PJG05/ESP32-Peltier-PCR-Thermal-Cycler/Hardware/CIRCUITCONNECTIONS.jpeg

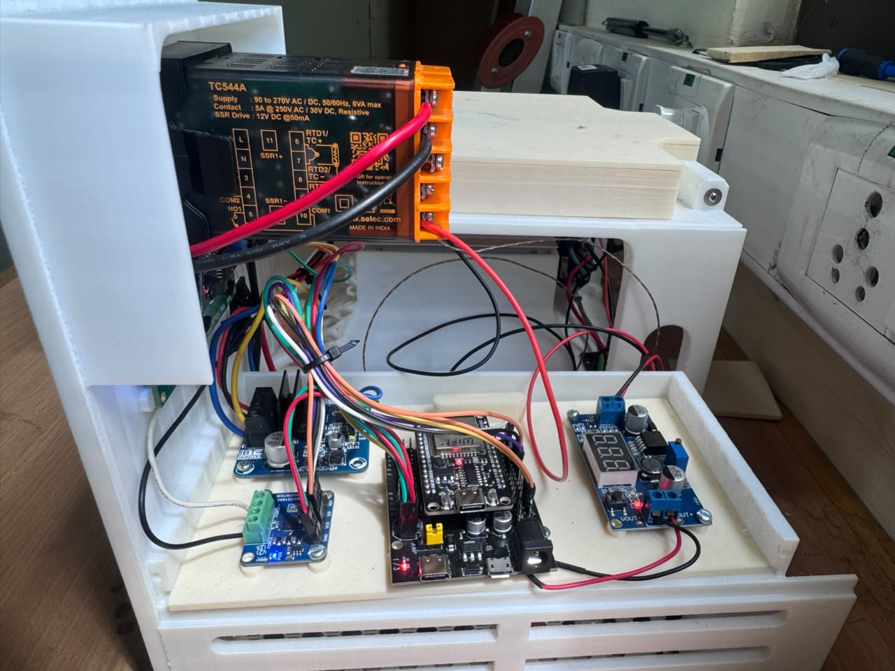
Hardware/CIRCUITCONNECTIONS.jpeg
