PJG05/ESP32-Peltier-PCR-Thermal-Cycler/Hardware/PCR.jpeg

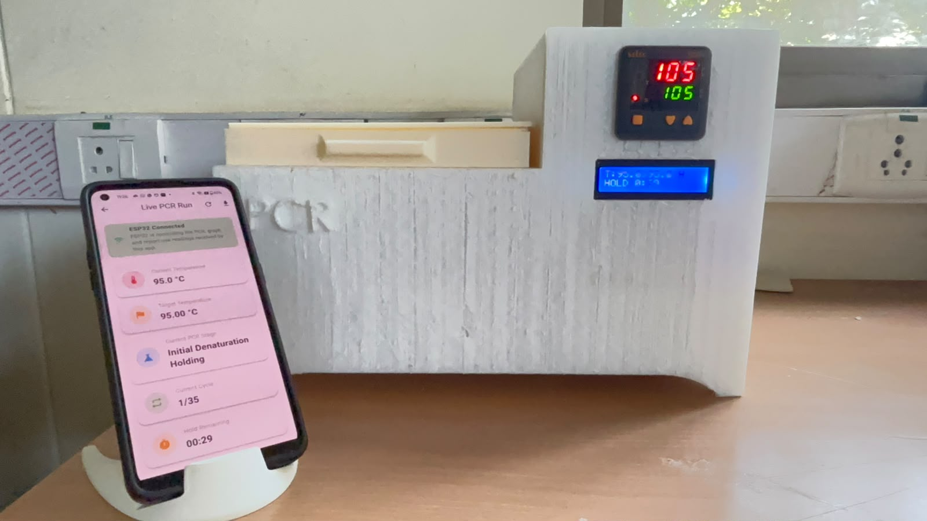
Hardware/PCR.jpeg
