PJG05/ESP32-Peltier-PCR-Thermal-Cycler/Firmware/README.md

# ESP32 Firmware

This directory contains the embedded firmware responsible for PCR temperature control, thermal cycling, telemetry, and communication.

## Main Components

- Temperature sensing and RTD interface
- PID temperature controller
- Peltier driver
- PCR state machine
- Wi-Fi HTTP server
- LCD interface
- Safety monitoring
- Telemetry and logging
