PJG05/ESP32-Peltier-PCR-Thermal-Cycler/Results/pcr_ieee_report.pdf

PCR CONTROLLER | PCR Run Report
PCR_Report_Test1_20261102_173332.pdf | Page 1 of 2

# PCR RUN REPORT

## Test1

Generated: 02/11/2026 17:33:32

## Run Summary

Parameter | Value
Program | Test1
Run Started | 02/11/2026 15:59:22
Report Generated | 02/11/2026 17:33:32
Run Duration | 1 h 34 min 9 sec
Number of Cycles | 30
Report Cycle Profile | Average of 30 cycles
Final ESP32 State | Running

## PCR Program Settings

Stage | Temperature | Hold Time
Initial Denaturation (T1) | 98.00 °C | 3 min 0 sec
Denaturation (T2) | 95.00 °C | 30 sec
Annealing (T3) | 60.00 °C | 30 sec
Extension (T4) | 72.00 °C | 1 min 0 sec
Final Extension (T5) | 72.00 °C | 5 min 0 sec

## Run Status

Parameter | Value
Current Temperature | 5.18 °C
Target Temperature | 4.00 °C

PCR CONTROLLER | PCR Run Report

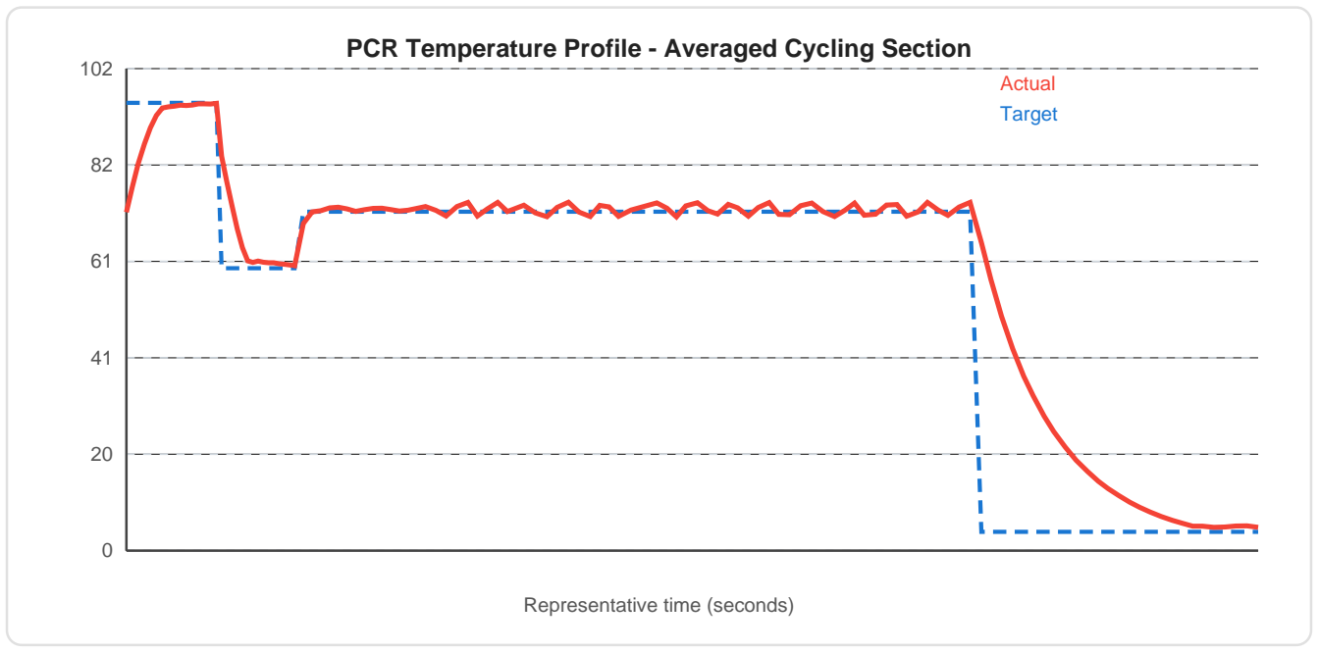
[picture p3: figure]
Actual Target; Representative time (seconds)

PCR_Report_Test1_20261102_173332.pdf | Page 2 of 2
Parameter | Value
Current Stage | Final Hold
Phase | Holding
Cycle | 30/30
Hold Remaining | 0 sec
Heater | OFF
Cooling | ON

## Temperature Profile

Initial denaturation, averaged cycling profile across N cycles, final extension, and actual cooling to the final hold.

PCR Temperature Profile - Averaged Cycling Section

The cycling section is aligned stage-by-stage and averaged across 30 recorded cycle(s). Raw ESP32 readings remain separate from the display-only HOLD smoothing used by the live UI.

Report note: PCR execution, stage transitions, cycle timing, heating and cooling are controlled by the ESP32. Flutter only records ESP32 status/temperature data and performs report post-processing. The averaged graph does not alter PCR control or timing on the ESP32.
