PJG05/ESP32-Peltier-PCR-Thermal-Cycler/Hardware/PCR Protype Design 1.png

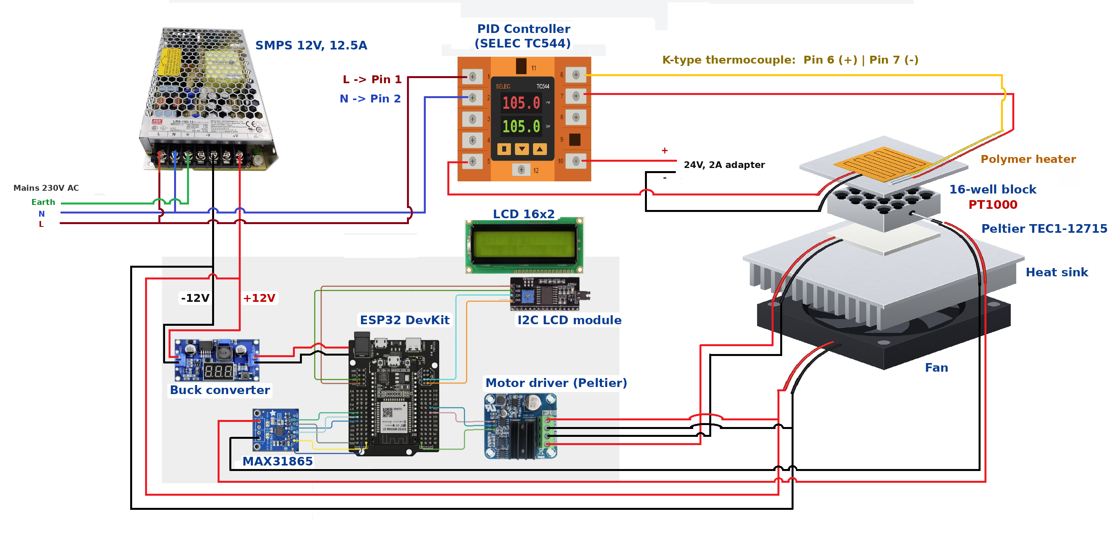
Hardware/PCR Protype Design 1.png
