PJG05/ESP32-Peltier-PCR-Thermal-Cycler/Firmware/config.cpp

#include "config.h"

//======================================================
// WiFi Credentials
//======================================================

const char* WIFI_SSID = "iPhone";
const char* WIFI_PASSWORD = "Prajwal@123";
