PJG05/ESP32-Peltier-PCR-Thermal-Cycler/(commit log)

2026-11-03 Create README.md for ESP32-Peltier PCR Thermal Cycler
    Added project overview, features, hardware, software, applications, and license information to README.
2026-11-03 Add README for ESP32 firmware components
2026-11-03 Add files via upload
    Upload ESP32 PCR firmware
2026-11-03 Add README for PCR thermal performance results
    This README provides details on the experimental evaluation and performance parameters of the ESP32-based Peltier PCR thermal cycler, including data types and objectives.
